shrutjain18/Robotic-Arm-Design-Lab/README.md

# Robotic-Arm-Design-Lab
Robotic Arm made under department elective design lab course. <br/>
Supervised and under guidance of Arun B. Aloshious.<br/>
Team:
- Shrut
- Srishti
