shrutjain18/Robotic-Arm-Design-Lab/3d_files/S3_S2_Motion_Capture.stl

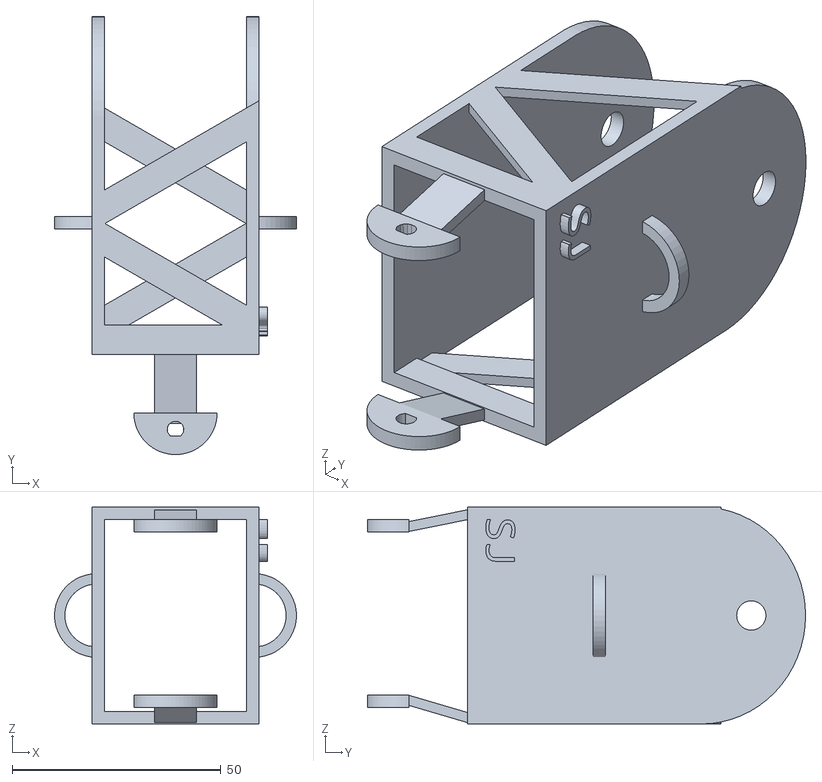
[picture p8: CAD file, 2026-05-27]
3d_files/S3_S2_Motion_Capture.stl
58.0 x 105.0 x 52.0
