shrutjain18/Robotic-Arm-Design-Lab/3d_files/End_Effect_Motion_Capture.stl

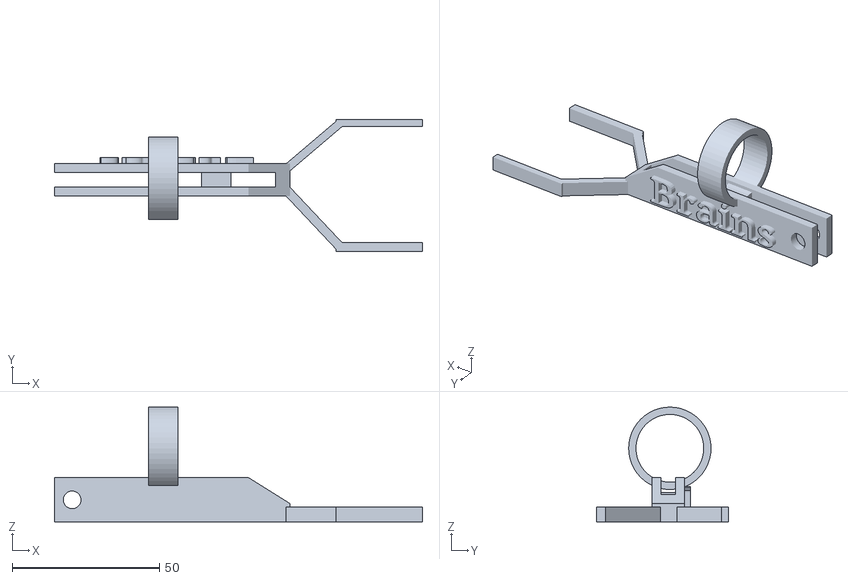
[picture p9: CAD file, 2026-05-27]
3d_files/End_Effect_Motion_Capture.stl
125.0 x 45.0 x 39.0
