shrutjain18/Robotic-Arm-Design-Lab/3d_files/Support_Shaft.stl

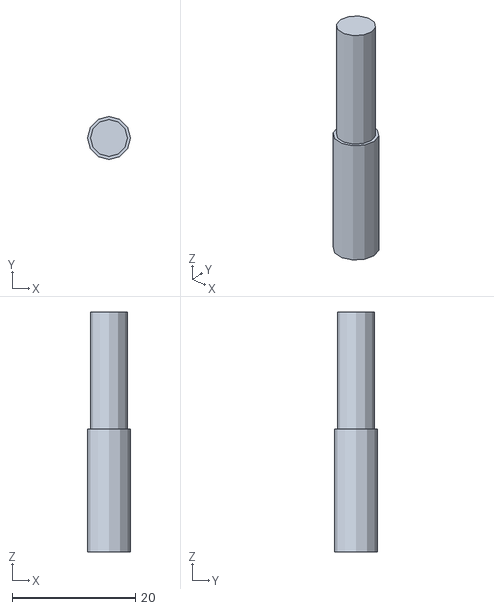
[picture p10: CAD file, 2026-05-27]
3d_files/Support_Shaft.stl
7.00 x 7.00 x 39.0
