shrutjain18/Robotic-Arm-Design-Lab/3d_files/Shaft connector_tolerance_check.stl

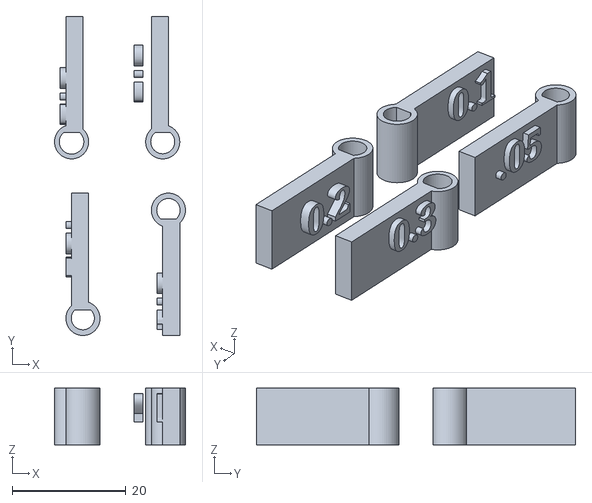
[picture p11: CAD file, 2026-05-27]
3d_files/Shaft connector_tolerance_check.stl
23.0 x 56.0 x 10.0
