shrutjain18/Robotic-Arm-Design-Lab/3d_files/stark_industries_logo.stl

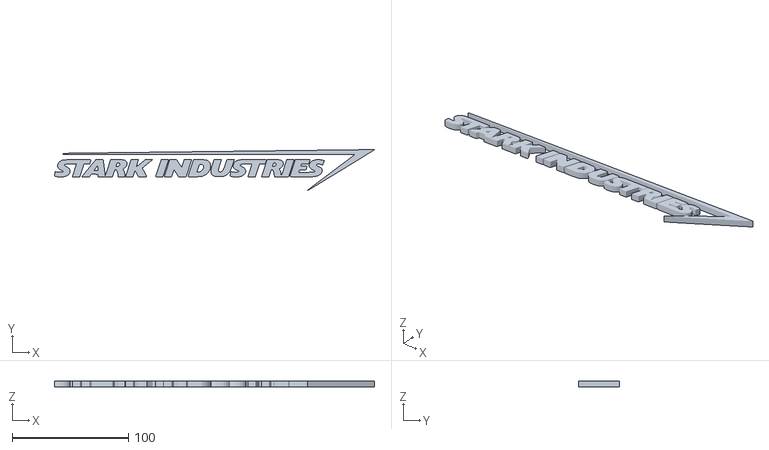
[picture p12: CAD file, 2026-05-27]
3d_files/stark_industries_logo.stl
274.7 x 35.1 x 5.00
