shrutjain18/Robotic-Arm-Design-Lab/3d_files/small_cuboid_for fitting.stl

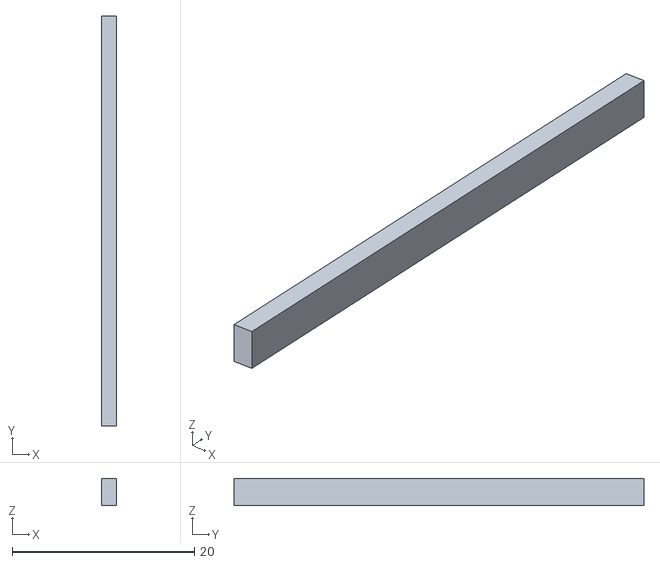
[picture p13: CAD file, 2026-05-27]
3d_files/small_cuboid_for fitting.stl
1.60 x 45.0 x 3.00
