shrutjain18/Robotic-Arm-Design-Lab/3d_files/S4_S3_Motion_Capture.stl

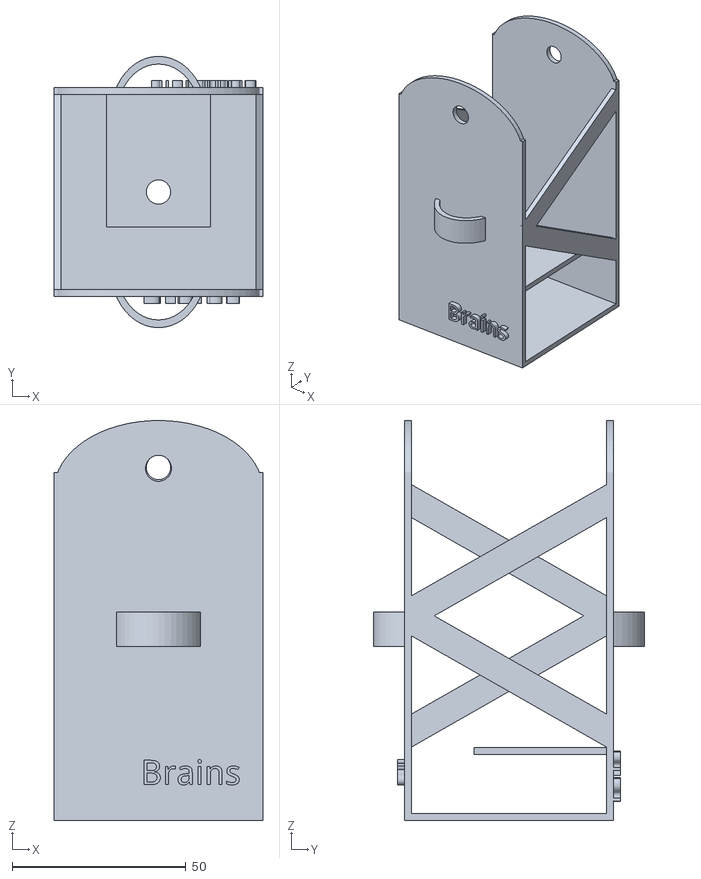
[picture p14: CAD file, 2026-05-27]
3d_files/S4_S3_Motion_Capture.stl
60.0 x 78.0 x 115.0
