shrutjain18/Robotic-Arm-Design-Lab/3d_files/Support_Ring.stl

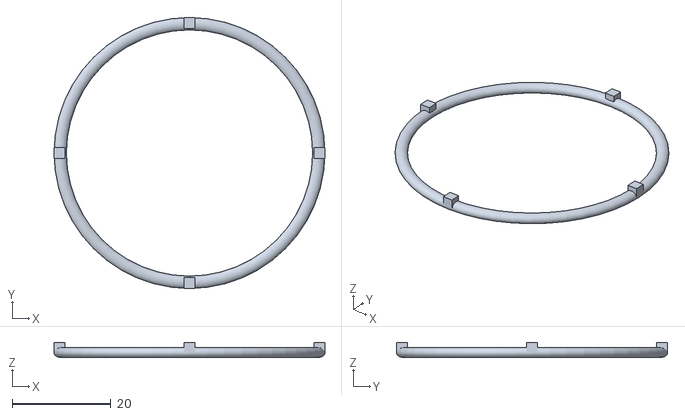
[picture p15: CAD file, 2026-05-27]
3d_files/Support_Ring.stl
55.0 x 55.0 x 3.00
