shrutjain18/Robotic-Arm-Design-Lab/3d_files/Shaft connector_2mm.stl

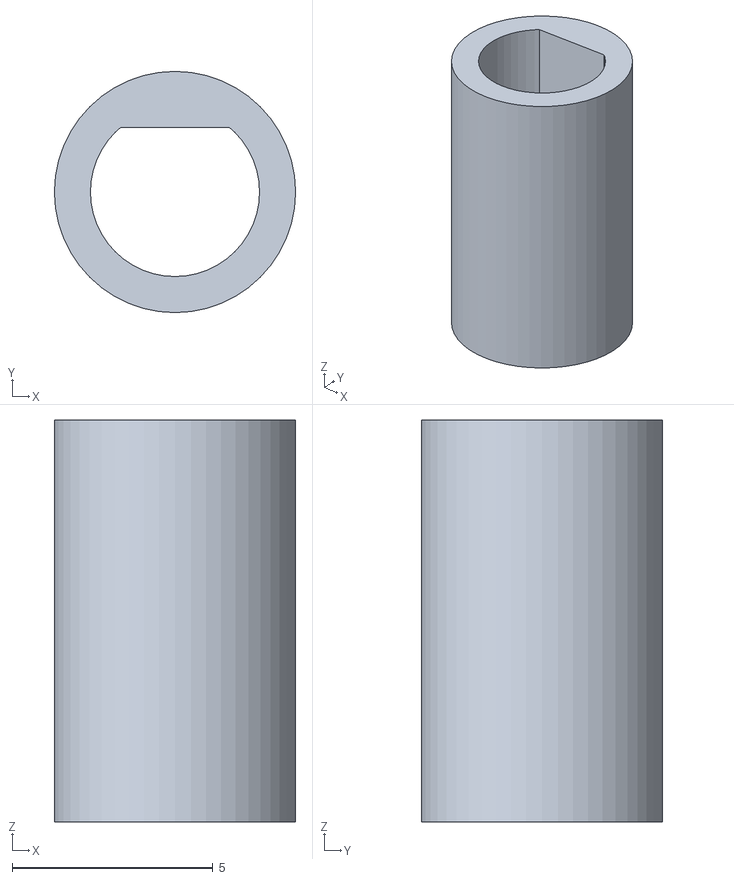
[picture p16: CAD file, 2026-05-27]
3d_files/Shaft connector_2mm.stl
6.00 x 6.00 x 10.0
