shrutjain18/Robotic-Arm-Design-Lab/3d_files/Base_head_Motion_Capture.stl

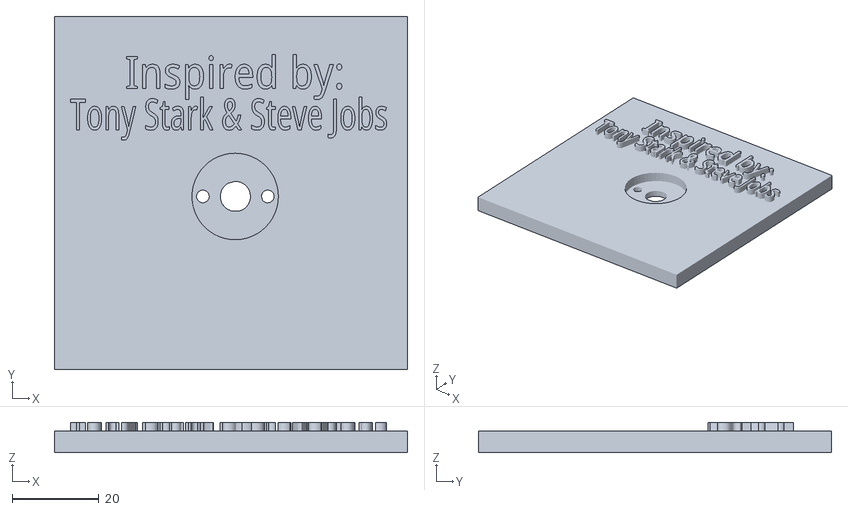
[picture p17: CAD file, 2026-05-27]
3d_files/Base_head_Motion_Capture.stl
81.6 x 81.6 x 7.00
