shrutjain18/Robotic-Arm-Design-Lab/3d_files/Base_Motion_Capture.stl

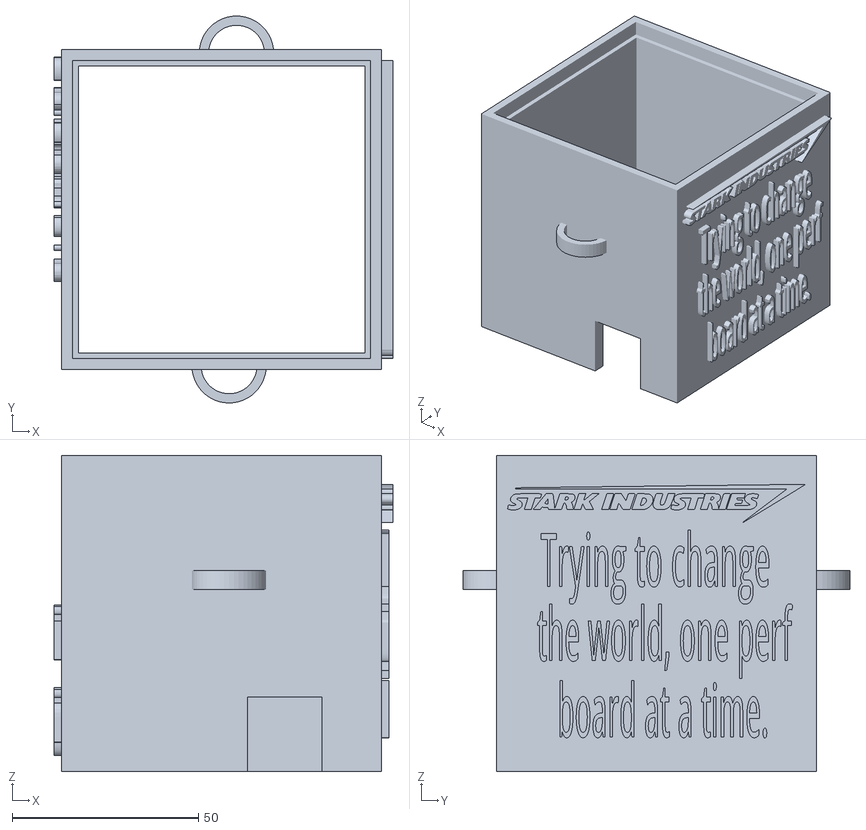
[picture p18: CAD file, 2026-05-27]
3d_files/Base_Motion_Capture.stl
91.0 x 104.0 x 85.0
