shrutjain18/Robotic-Arm-Design-Lab/3d_files/Perf Board holder.stl

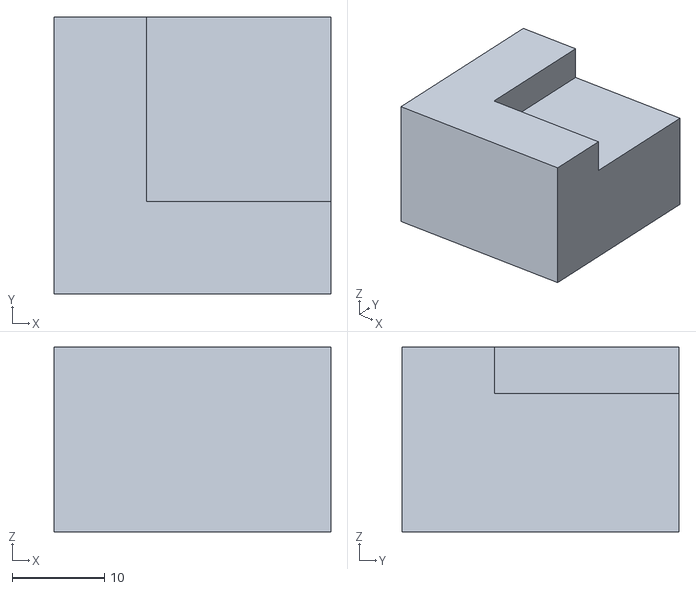
[picture p19: CAD file, 2026-05-27]
3d_files/Perf Board holder.stl
30.0 x 30.0 x 20.0
