shrutjain18/Robotic-Arm-Design-Lab/3d_files/Motor.stl

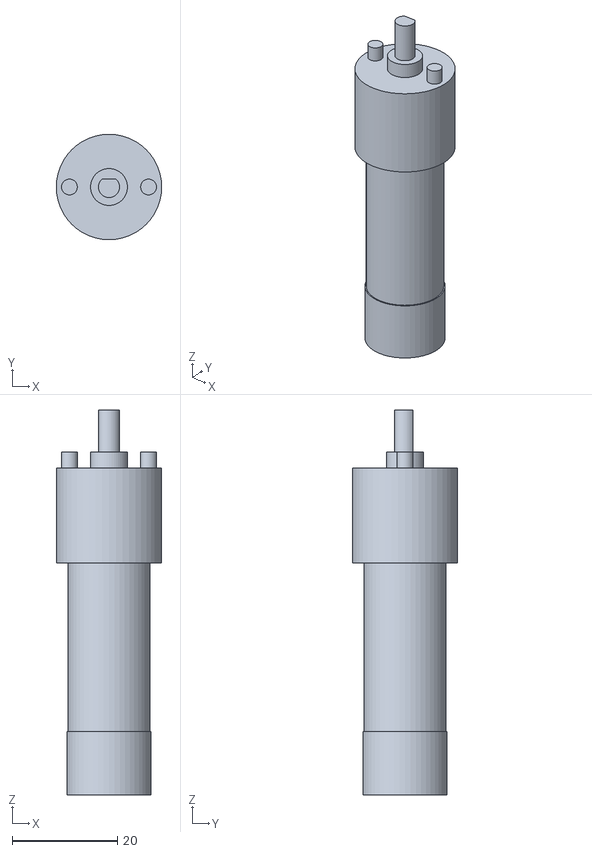
[picture p20: CAD file, 2026-03-28]
3d_files/Motor.stl
20.0 x 20.0 x 73.0
