shrutjain18/Robotic-Arm-Design-Lab/3d_files/Potentiometer.stl

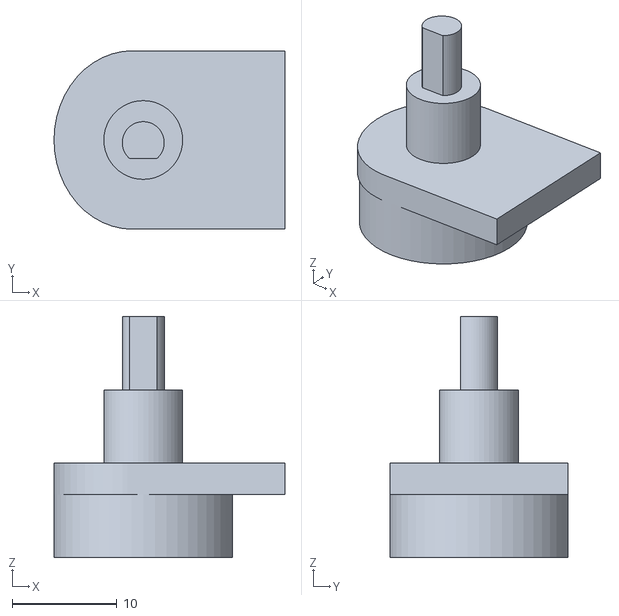
[picture p21: CAD file, 2026-03-28]
3d_files/Potentiometer.stl
22.0 x 17.0 x 23.0
