shrutjain18/Robotic-Arm-Design-Lab/3d_files/S2_S1.stl

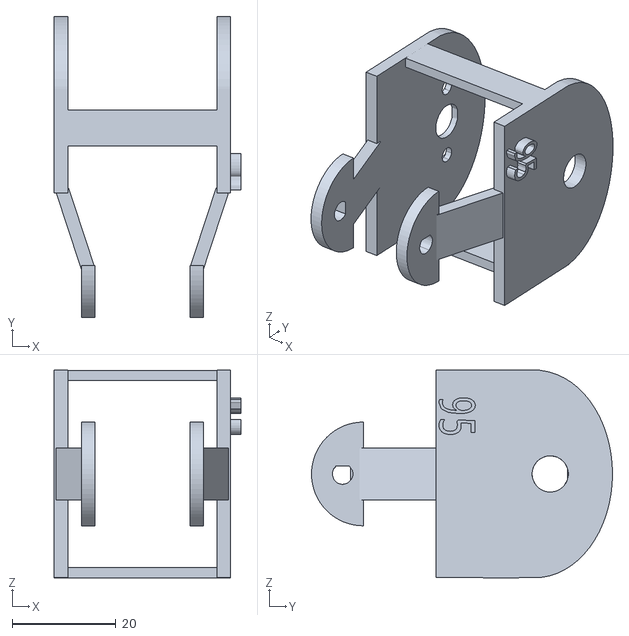
[picture p22: CAD file, 2026-03-28]
3d_files/S2_S1.stl
36.0 x 58.0 x 40.0
