shrutjain18/Robotic-Arm-Design-Lab/3d_files/Base.stl

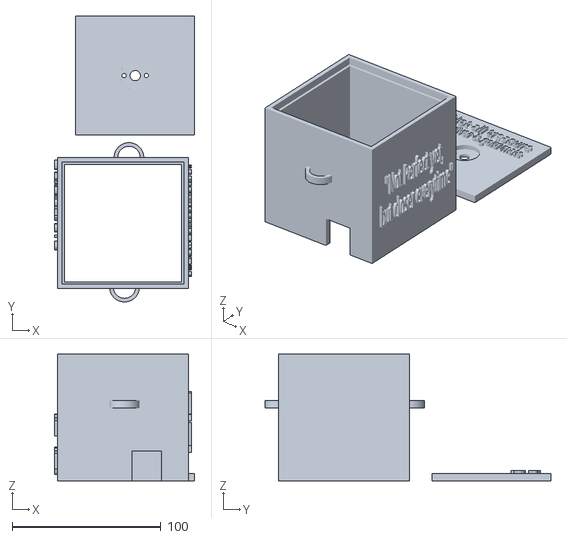
[picture p23: CAD file, 2026-03-28]
3d_files/Base.stl
94.0 x 192.0 x 85.0
