shrutjain18/Robotic-Arm-Design-Lab/3d_files/End_Effect.stl

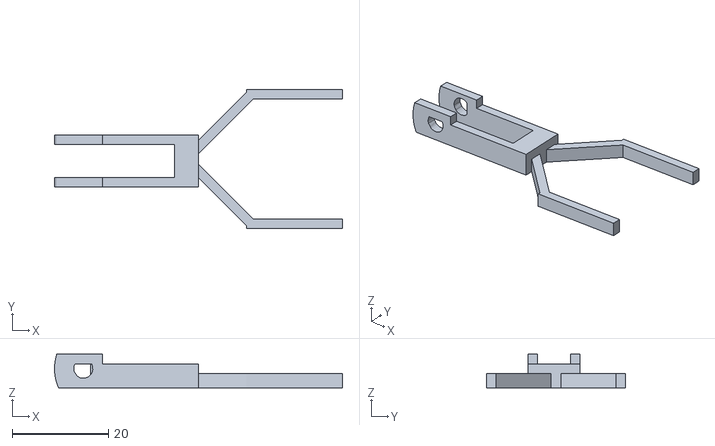
[picture p24: CAD file, 2026-03-28]
3d_files/End_Effect.stl
60.0 x 29.0 x 7.00
