shrutjain18/Robotic-Arm-Design-Lab/(list of files, cad)

Other CAD files:
3d_files/S3_S2.stl
3d_files/S4_S3.stl
