shrutjain18/Robotic-Arm-Design-Lab/Design Lab Flow Chart.pdf

# Start

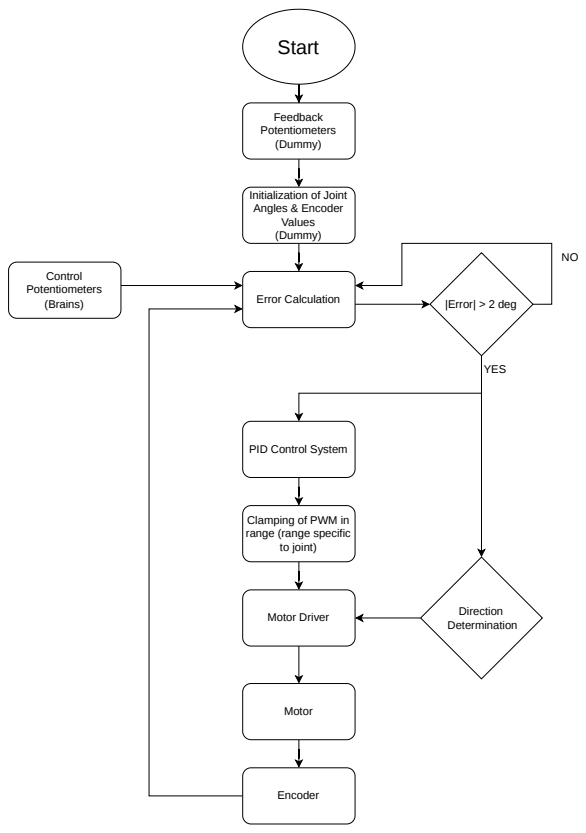
[picture p25: page 1]
Feedback Potentiometers (Dummy); Control Potentiometers (Brains); Error Calculation; |Error| > 2 deg; Motor Driver; Motor; Direction Determination; Encoder; YES

Initialization of Joint
Angles & Encoder
Values
(Dummy)

PID Control System

Clamping of PWM in
range (range specific
to joint)
