shrutjain18/Robotic-Arm-Design-Lab/circuit_diagrams.pdf

# circuit

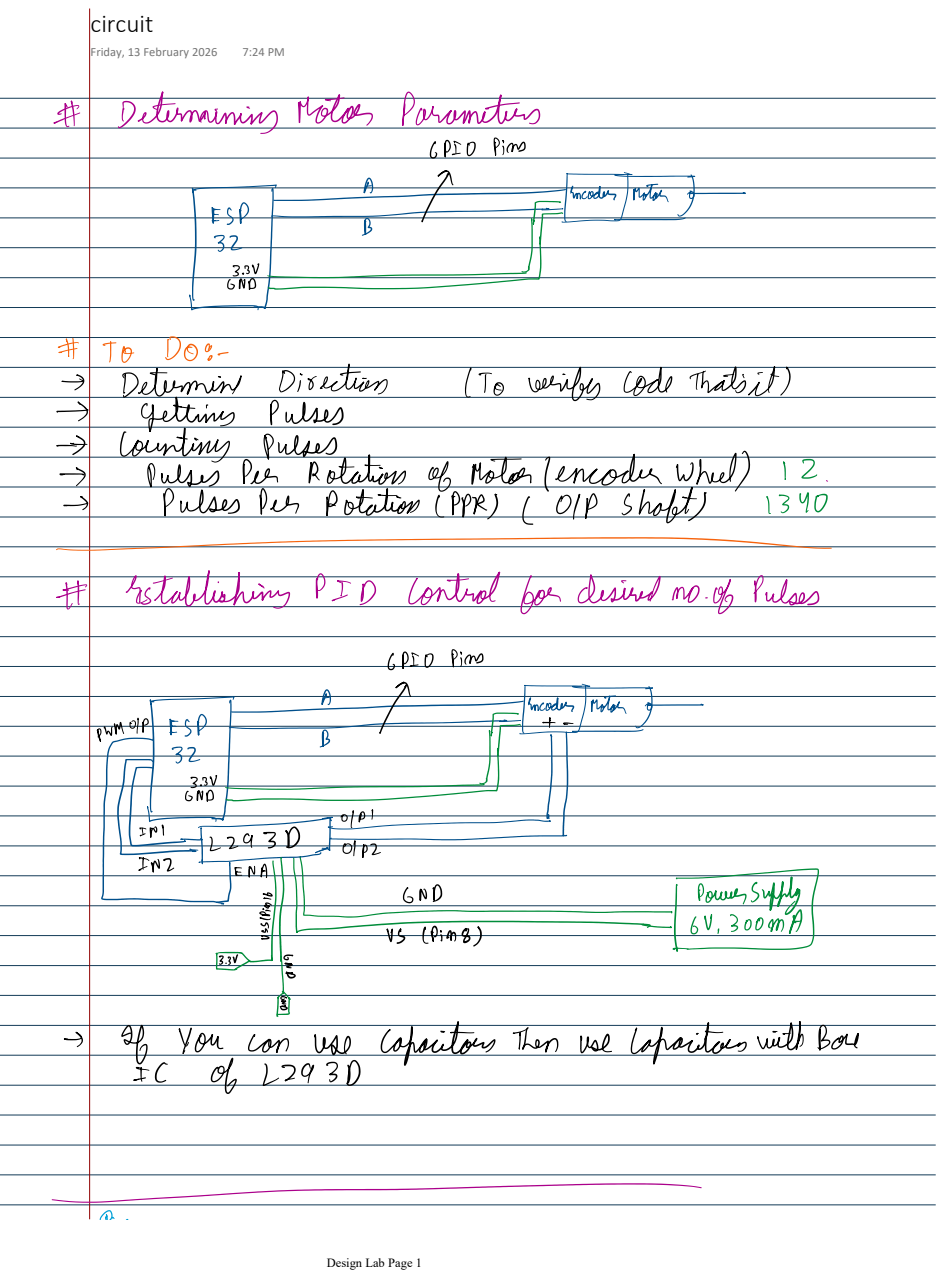
[picture p26: page 1]
Friday, 13 February 2026

Design Lab Page 1

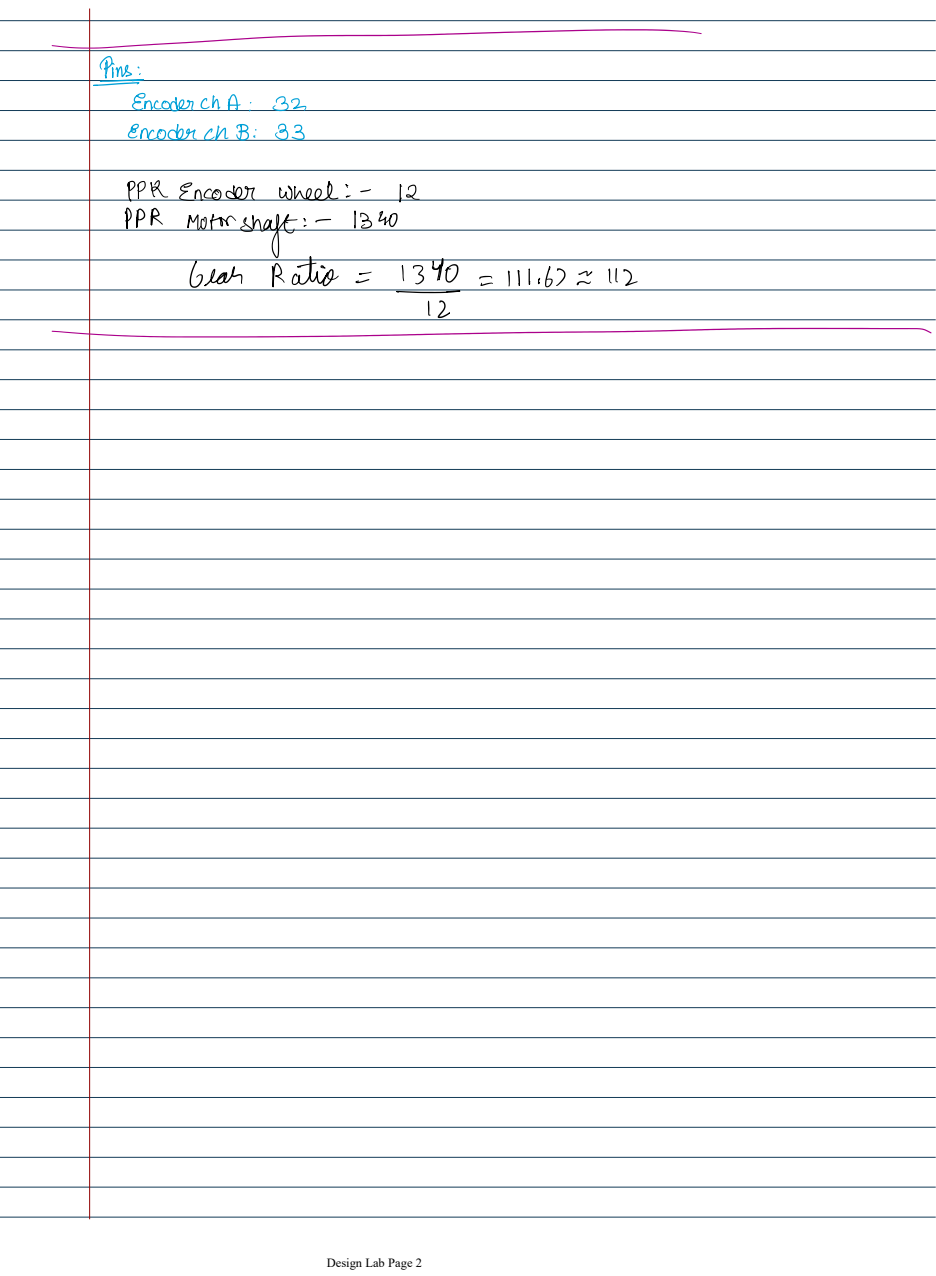
[picture p27: page 2]

Design Lab Page 2
