shrutjain18/Robotic-Arm-Design-Lab/(commit log)

2026-02-14 Add project timeline for 5-DoF robotic arm
    Document the development progress of a 5-DoF robotic arm, including procurement, testing, calibration, and upcoming objectives.
2026-02-14 Create PWM Speed Control.ino
2026-02-14 Create Motor Testing.ino
2026-02-14 Add encoder testing code for motor shaft rotation
2026-02-14 Rename Motor Testing.ino to Motor Testing.ino
2026-02-14 Add PWM Speed Control Arduino sketch
2026-02-14 Rename encoder testing.ino to encoder testing.ino
2026-02-14 Rename circuit diagrams.pdf to circuit_diagrams.pdf
2026-03-28 Add printing elements section to time_line.md
    Added a new section for printing elements and their checks.
2026-04-06 Implement absolute position control for motors
    Added initialization logic for absolute position feedback using potentiometers for two motors.
2026-04-06 Implement motor control with PID and feedback pots
    Added motor control logic with PID for two motors and feedback potentiometers.
2026-04-16 Implement motor control with PID and feedback pots
    Added motor control code with PID for two motors and feedback pots.
2026-04-22 Create stage2_esp1_final
2026-04-22 Create Stage2_esp2_final
2026-05-27 Rename Shaft connector.stl to Shaft connector_tolerance_check.stl
    [Shaft connector_tolerance_check.stl]
